DavenportEmma/sequencer/hardware/pcb/io/rotary-encoder-PEC11R-main/Bourns_-_PEC11R-4220F-S0024.step

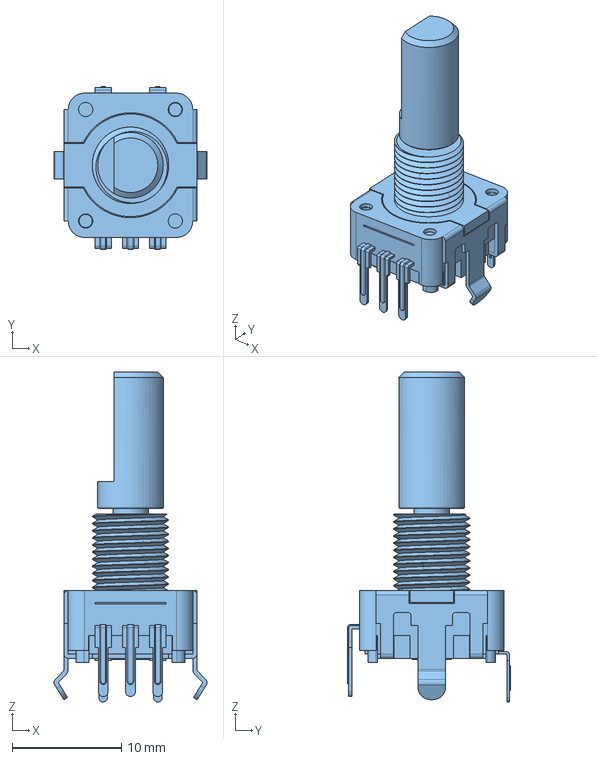
[picture p1: CAD file, 2025-04-29]
hardware/pcb/io/rotary-encoder-PEC11R-main/Bourns_-_PEC11R-4220F-S0024.step
14.0 x 14.9 x 30.2 mm
