DavenportEmma/sequencer/hardware/pcb/nucleo-hat/nucleo-hat.kicad_pcb

## KiCad design hardware/pcb/nucleo-hat/nucleo-hat.kicad_pcb (2025-05-08)

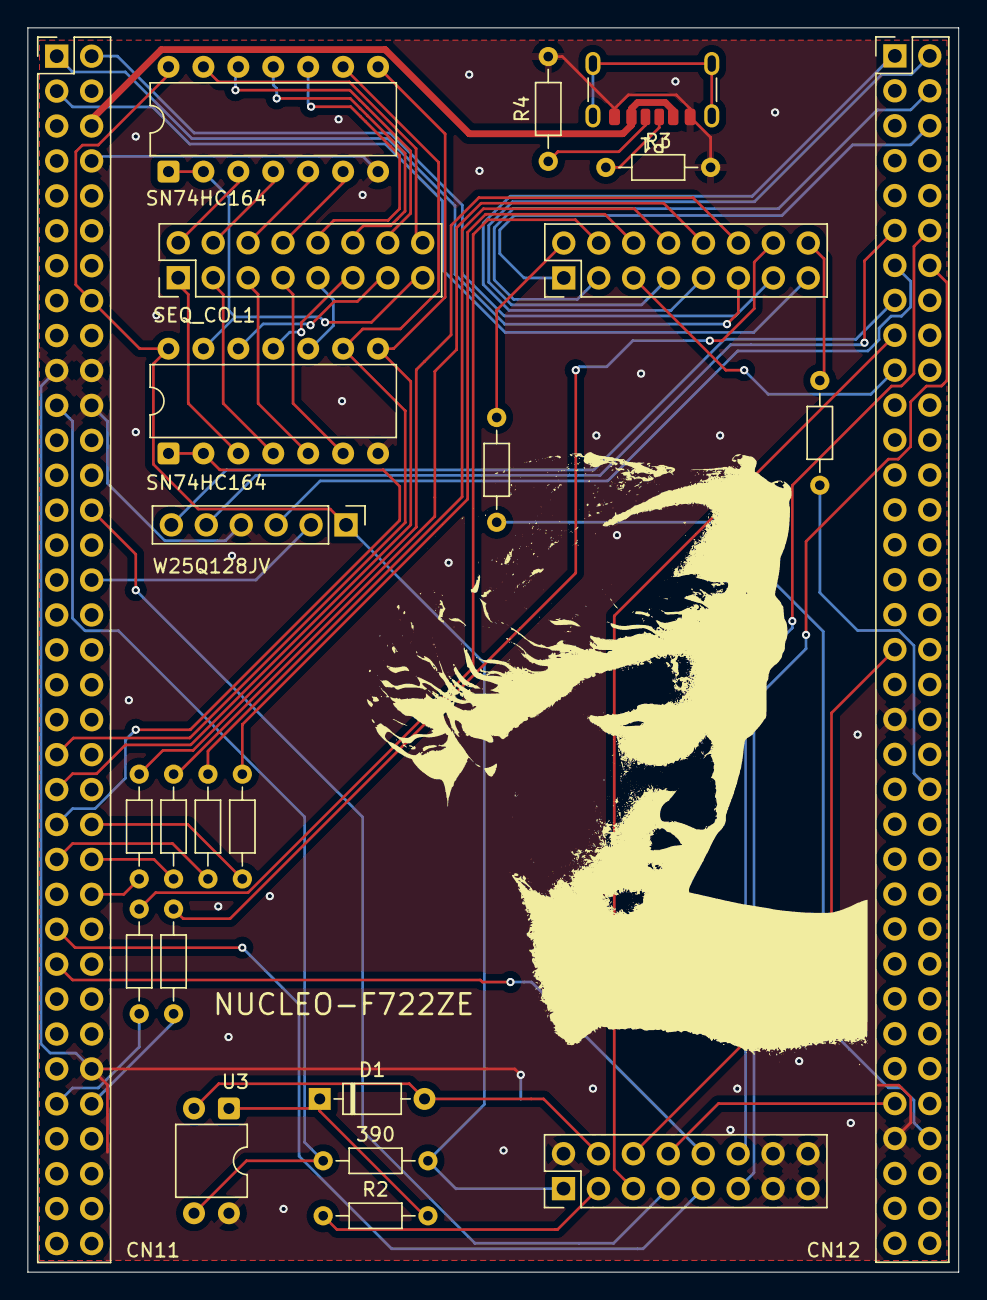
[picture p2: board nucleo-hat.kicad_pcb from above]

Board: 2 copper layers, 67.7 x 90.5 mm, 23 parts (0 on the bottom side), 64 nets.

Parts:
390: 390; R_Axial_DIN0204_L3.6mm_D1.6mm_P7.62mm_Horizontal
CN11, CN12: Conn_02x35_Odd_Even; PinHeader_2x35_P2.54mm_Vertical
D1: D; D_DO-35_SOD27_P7.62mm_Horizontal
IO1: Conn_02x08_Odd_Even; PinHeader_2x08_P2.54mm_Vertical
P1: USB_C_Plug_USB2.0; USB_C_Receptacle_GCT_USB4125-xx-x-0190_6P_TopMnt_Horizontal
R2: 330; R_Axial_DIN0204_L3.6mm_D1.6mm_P7.62mm_Horizontal
R3, R4: 1K5; R_Axial_DIN0204_L3.6mm_D1.6mm_P7.62mm_Horizontal
R5, R6, R7, R8, R9, R10, R11, R12: R; R_Axial_DIN0204_L3.6mm_D1.6mm_P7.62mm_Horizontal
SEQ_COL1: Conn_02x08_Odd_Even; PinHeader_2x08_P2.54mm_Vertical
SEQ_ROW1: Conn_02x08_Odd_Even; PinHeader_2x08_P2.54mm_Vertical
SN74HC164, SN74HC164#2: 74HC164; DIP-14_W7.62mm
U3: SFH617A-1; DIP-4_W7.62mm
W25Q128JV : Conn_01x06; PinHeader_1x06_P2.54mm_Vertical

Connections:
3.3: 390.2, CN11.16, IO1.1, SN74HC164.14 (VCC), SN74HC164#2.14 (VCC), W25Q128JV.1
E5V: CN11.6, P1.A9 (VBUS), P1.B9 (VBUS)
GND: CN11.8, CN11.19, CN11.20, CN11.22, CN11.60, CN12.39, CN12.63, IO1.2, IO1.13, IO1.14, IO1.15, IO1.16, P1.A12 (GND), P1.B12 (GND), R3.2, R4.2, SN74HC164.7 (GND), SN74HC164#2.7 (GND), U3.4, W25Q128JV.4
MIDI_IN_GND: D1.2 (A), IO1.4, U3.2
MIDI_IN_SRC: IO1.3, R2.1
unnamed: D1.1 (K), R2.2, U3.1
unnamed: P1.A5 (CC), R3.1
unnamed: P1.B5 (VCONN), R4.1
unnamed: SEQ_COL1.1, SN74HC164#2.3 (Q0)
unnamed: SEQ_COL1.2, SN74HC164.3 (Q0)
unnamed: SEQ_COL1.3, SN74HC164#2.4 (Q1)
unnamed: SEQ_COL1.4, SN74HC164.4 (Q1)
unnamed: SEQ_COL1.5, SN74HC164#2.5 (Q2)
unnamed: SEQ_COL1.6, SN74HC164.5 (Q2)
unnamed: SEQ_COL1.7, SN74HC164#2.6 (Q3)
unnamed: SEQ_COL1.8, SN74HC164.6 (Q3)
unnamed: SEQ_COL1.9, SN74HC164#2.10 (Q4)
unnamed: SEQ_COL1.10, SN74HC164.10 (Q4)
unnamed: SEQ_COL1.11, SN74HC164#2.11 (Q5)
unnamed: SEQ_COL1.12, SN74HC164.11 (Q5)
unnamed: SEQ_COL1.13, SN74HC164#2.12 (Q6)
unnamed: SEQ_COL1.14, SN74HC164.12 (Q6)
unnamed: SEQ_COL1.16, SN74HC164.13 (Q7)
unnamed: R5.1, SEQ_ROW1.2
unnamed: R6.1, SEQ_ROW1.4
unnamed: R7.1, SEQ_ROW1.6
unnamed: R8.1, SEQ_ROW1.8
unnamed: R9.1, SEQ_ROW1.10
unnamed: R10.1, SEQ_ROW1.12
unnamed: R11.1, SEQ_ROW1.14
unnamed: R12.1, SEQ_ROW1.16
PA0: CN11.28, IO1.7
PA2: CN12.35, IO1.6
PA4: CN11.32, W25Q128JV.2
PA5: CN12.11, W25Q128JV.5
PA6: CN12.13, W25Q128JV.3
PA7: CN12.15, W25Q128JV.6
PA11: CN12.14, IO1.11
PA12: CN12.12, IO1.12
PB6: CN12.17, IO1.5
PB7: 390.1, CN11.21, U3.3
PC5: CN12.6, SEQ_ROW1.1
PC6: CN12.4, SEQ_ROW1.3
PC7: CN12.19, SEQ_ROW1.5
PC8: CN12.2, SEQ_ROW1.7
PC9: CN12.1, SEQ_ROW1.9
PC10: CN11.1, SEQ_ROW1.11
PC11: CN11.2, SEQ_ROW1.13
PC12: CN11.3, SEQ_ROW1.15
PD5: CN11.41, SN74HC164.9 (~MR), SN74HC164#2.9 (~MR)
PD6: CN11.43, SN74HC164.8 (CP), SN74HC164#2.8 (CP)
PD7: CN11.45, SN74HC164#2.1 (DSA), SN74HC164#2.2 (DSB)
PE0: CN12.64, R5.2
PE1: CN11.61, R6.2
PE2: CN11.46, R7.2
PE3: CN11.47, R8.2
PE4: CN11.48, R9.2
PE5: CN11.50, R10.2
PE6: CN11.62, R11.2
PE7: CN12.44, R12.2
PF0: CN11.53, IO1.10
PF1: CN11.51, IO1.9
PG14: CN12.61, IO1.8
Q8: SEQ_COL1.15, SN74HC164.1 (DSA), SN74HC164.2 (DSB), SN74HC164#2.13 (Q7)
