DavenportEmma/sequencer/hardware/pcb/sequencer/sequencer.kicad_pcb

## KiCad design hardware/pcb/sequencer/sequencer.kicad_pcb (2025-04-29)

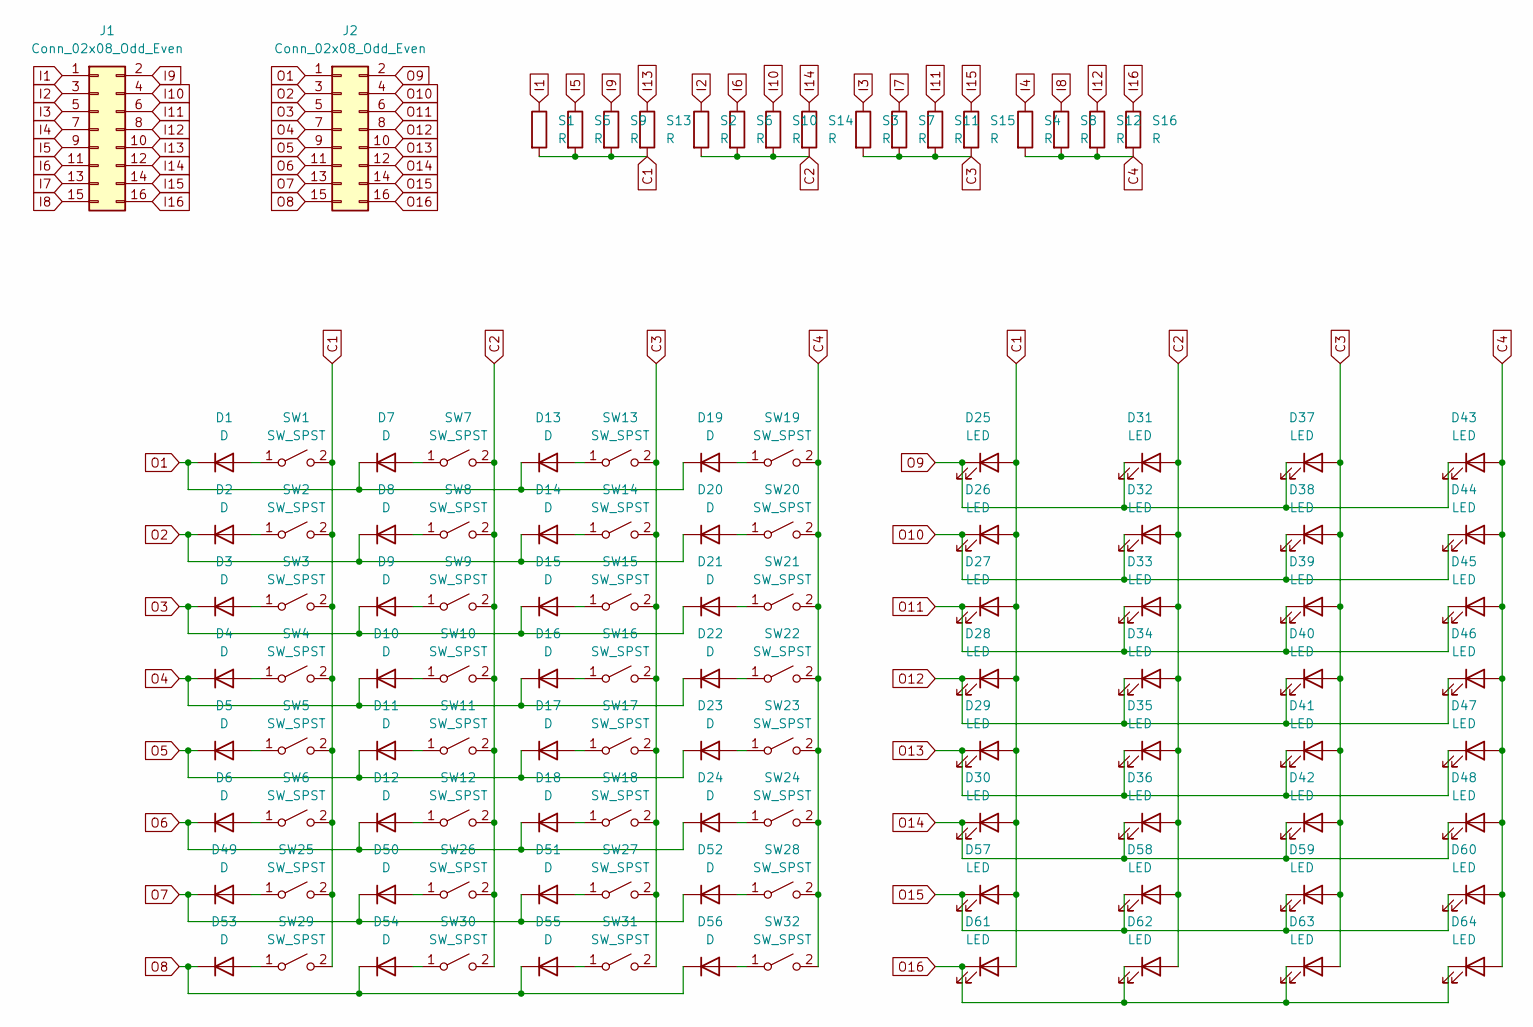
[picture p3: schematic sequencer.kicad_sch]

Parts:
D1, D2, D3, D4, D5, D6, D7, D8, D9, D10, D11, D12, D13, D14, D15, D16, D17, D18, D19, D20, D21, D22, D23, D24, D49, D50, D51, D52, D53, D54, D55, D56: D; D_DO-35_SOD27_P7.62mm_Horizontal
D25, D26, D27, D28, D29, D30, D31, D32, D33, D34, D35, D36, D37, D38, D39, D40, D41, D42, D43, D44, D45, D46, D47, D48, D57, D58, D59, D60, D61, D62, D63, D64: LED; LED_0805_2012Metric
J1, J2: Conn_02x08_Odd_Even; PinHeader_2x08_P2.54mm_Vertical
S1, S2, S3, S4, S5, S6, S7, S8, S9, S10, S11, S12, S13, S14, S15, S16: R; R_0603_1608Metric
SW1, SW2, SW3, SW4, SW5, SW6, SW7, SW8, SW9, SW10, SW11, SW12, SW13, SW14, SW15, SW16, SW17, SW18, SW19, SW20, SW21, SW22, SW23, SW24, SW25, SW26, SW27, SW28, SW29, SW30, SW31, SW32: SW_SPST; SW_Cherry_MX_1.00u_PCB

Connections:
C1: D25.2 (A), D26.2 (A), D27.2 (A), D28.2 (A), D29.2 (A), D30.2 (A), D57.2 (A), D61.2 (A), S1.2, S5.2, S9.2, S13.2, SW1.2 (B), SW2.2 (B), SW3.2 (B), SW4.2 (B), SW5.2 (B), SW6.2 (B), SW25.2 (B), SW29.2 (B)
C2: D31.2 (A), D32.2 (A), D33.2 (A), D34.2 (A), D35.2 (A), D36.2 (A), D58.2 (A), D62.2 (A), S2.2, S6.2, S10.2, S14.2, SW7.2 (B), SW8.2 (B), SW9.2 (B), SW10.2 (B), SW11.2 (B), SW12.2 (B), SW26.2 (B), SW30.2 (B)
C3: D37.2 (A), D38.2 (A), D39.2 (A), D40.2 (A), D41.2 (A), D42.2 (A), D59.2 (A), D63.2 (A), S3.2, S7.2, S11.2, S15.2, SW13.2 (B), SW14.2 (B), SW15.2 (B), SW16.2 (B), SW17.2 (B), SW18.2 (B), SW27.2 (B), SW31.2 (B)
C4: D43.2 (A), D44.2 (A), D45.2 (A), D46.2 (A), D47.2 (A), D48.2 (A), D60.2 (A), D64.2 (A), S4.2, S8.2, S12.2, S16.2, SW19.2 (B), SW20.2 (B), SW21.2 (B), SW22.2 (B), SW23.2 (B), SW24.2 (B), SW28.2 (B), SW32.2 (B)
I1: J1.1, S1.1
I2: J1.3, S2.1
I3: J1.5, S3.1
I4: J1.7, S4.1
I5: J1.9, S5.1
I6: J1.11, S6.1
I7: J1.13, S7.1
I8: J1.15, S8.1
I9: J1.2, S9.1
I10: J1.4, S10.1
I11: J1.6, S11.1
I12: J1.8, S12.1
I13: J1.10, S13.1
I14: J1.12, S14.1
I15: J1.14, S15.1
I16: J1.16, S16.1
unnamed: D1.2 (A), SW1.1 (A)
unnamed: D2.2 (A), SW2.1 (A)
unnamed: D3.2 (A), SW3.1 (A)
unnamed: D4.2 (A), SW4.1 (A)
unnamed: D5.2 (A), SW5.1 (A)
unnamed: D6.2 (A), SW6.1 (A)
unnamed: D7.2 (A), SW7.1 (A)
unnamed: D8.2 (A), SW8.1 (A)
unnamed: D9.2 (A), SW9.1 (A)
unnamed: D10.2 (A), SW10.1 (A)
unnamed: D11.2 (A), SW11.1 (A)
unnamed: D12.2 (A), SW12.1 (A)
unnamed: D13.2 (A), SW13.1 (A)
unnamed: D14.2 (A), SW14.1 (A)
unnamed: D15.2 (A), SW15.1 (A)
unnamed: D16.2 (A), SW16.1 (A)
unnamed: D17.2 (A), SW17.1 (A)
unnamed: D18.2 (A), SW18.1 (A)
unnamed: D19.2 (A), SW19.1 (A)
unnamed: D20.2 (A), SW20.1 (A)
unnamed: D21.2 (A), SW21.1 (A)
unnamed: D22.2 (A), SW22.1 (A)
unnamed: D23.2 (A), SW23.1 (A)
unnamed: D24.2 (A), SW24.1 (A)
unnamed: D49.2 (A), SW25.1 (A)
unnamed: D50.2 (A), SW26.1 (A)
unnamed: D51.2 (A), SW27.1 (A)
unnamed: D52.2 (A), SW28.1 (A)
unnamed: D53.2 (A), SW29.1 (A)
unnamed: D54.2 (A), SW30.1 (A)
unnamed: D55.2 (A), SW31.1 (A)
unnamed: D56.2 (A), SW32.1 (A)
O1: D1.1 (K), D7.1 (K), D13.1 (K), D19.1 (K), J2.1
O2: D2.1 (K), D8.1 (K), D14.1 (K), D20.1 (K), J2.3
O3: D3.1 (K), D9.1 (K), D15.1 (K), D21.1 (K), J2.5
O4: D4.1 (K), D10.1 (K), D16.1 (K), D22.1 (K), J2.7
O5: D5.1 (K), D11.1 (K), D17.1 (K), D23.1 (K), J2.9
O6: D6.1 (K), D12.1 (K), D18.1 (K), D24.1 (K), J2.11
O7: D49.1 (K), D50.1 (K), D51.1 (K), D52.1 (K), J2.13
O8: D53.1 (K), D54.1 (K), D55.1 (K), D56.1 (K), J2.15
O9: D25.1 (K), D31.1 (K), D37.1 (K), D43.1 (K), J2.2
O10: D26.1 (K), D32.1 (K), D38.1 (K), D44.1 (K), J2.4
O11: D27.1 (K), D33.1 (K), D39.1 (K), D45.1 (K), J2.6
O12: D28.1 (K), D34.1 (K), D40.1 (K), D46.1 (K), J2.8
O13: D29.1 (K), D35.1 (K), D41.1 (K), D47.1 (K), J2.10
O14: D30.1 (K), D36.1 (K), D42.1 (K), D48.1 (K), J2.12
O15: D57.1 (K), D58.1 (K), D59.1 (K), D60.1 (K), J2.14
O16: D61.1 (K), D62.1 (K), D63.1 (K), D64.1 (K), J2.16

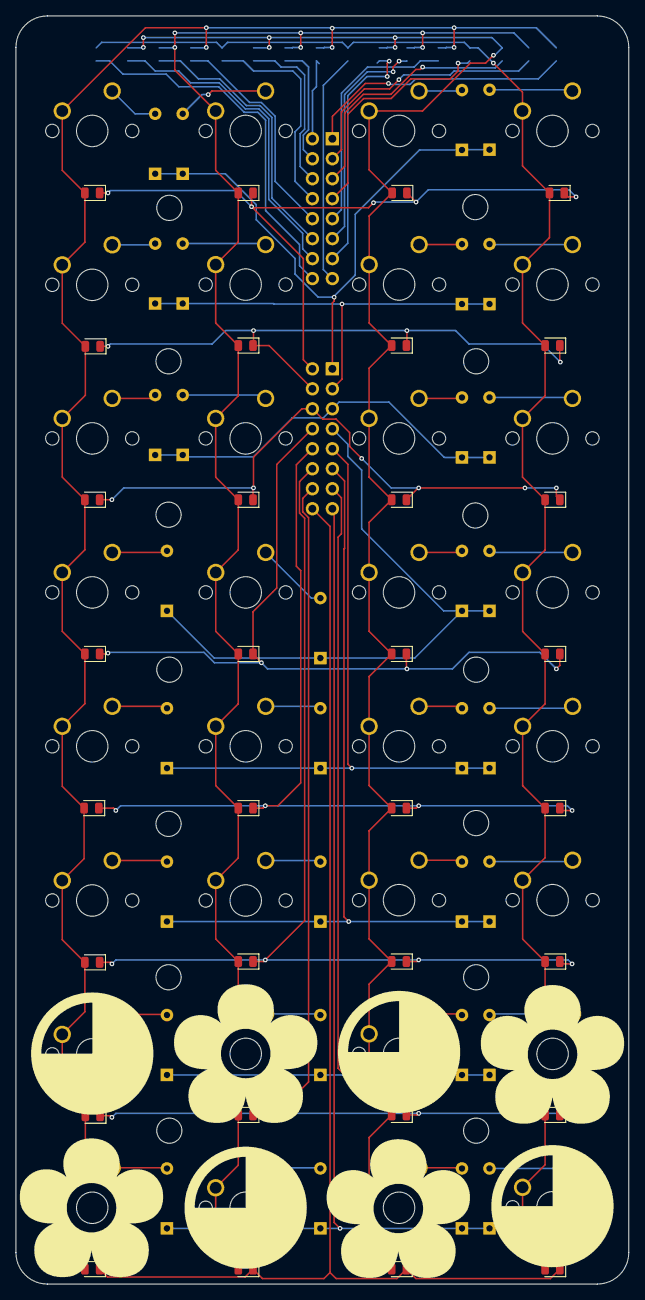
[picture p4: board sequencer.kicad_pcb from above]

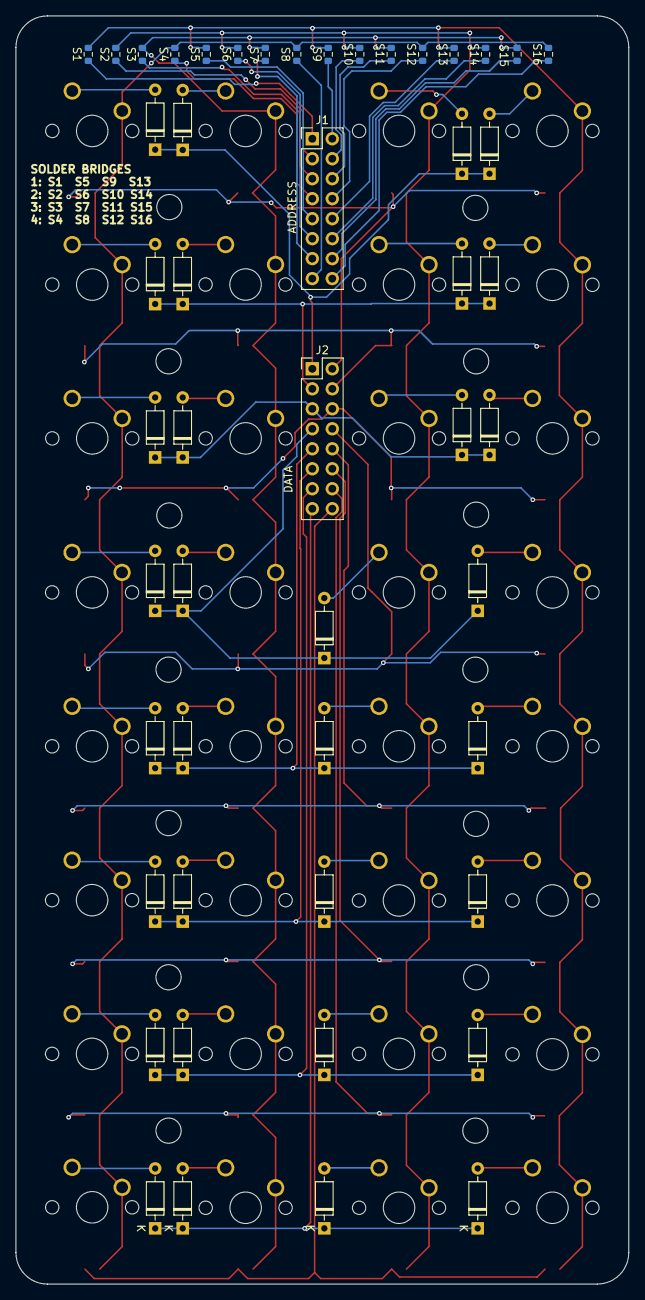
[picture p5: board sequencer.kicad_pcb from below]

Board: 2 copper layers, 77.9 x 161.2 mm, 114 parts (50 on the bottom side), 68 nets.
