DavenportEmma/sequencer/hardware/pcb/io/io.kicad_pcb

## KiCad design hardware/pcb/io/io.kicad_pcb (2025-04-29)

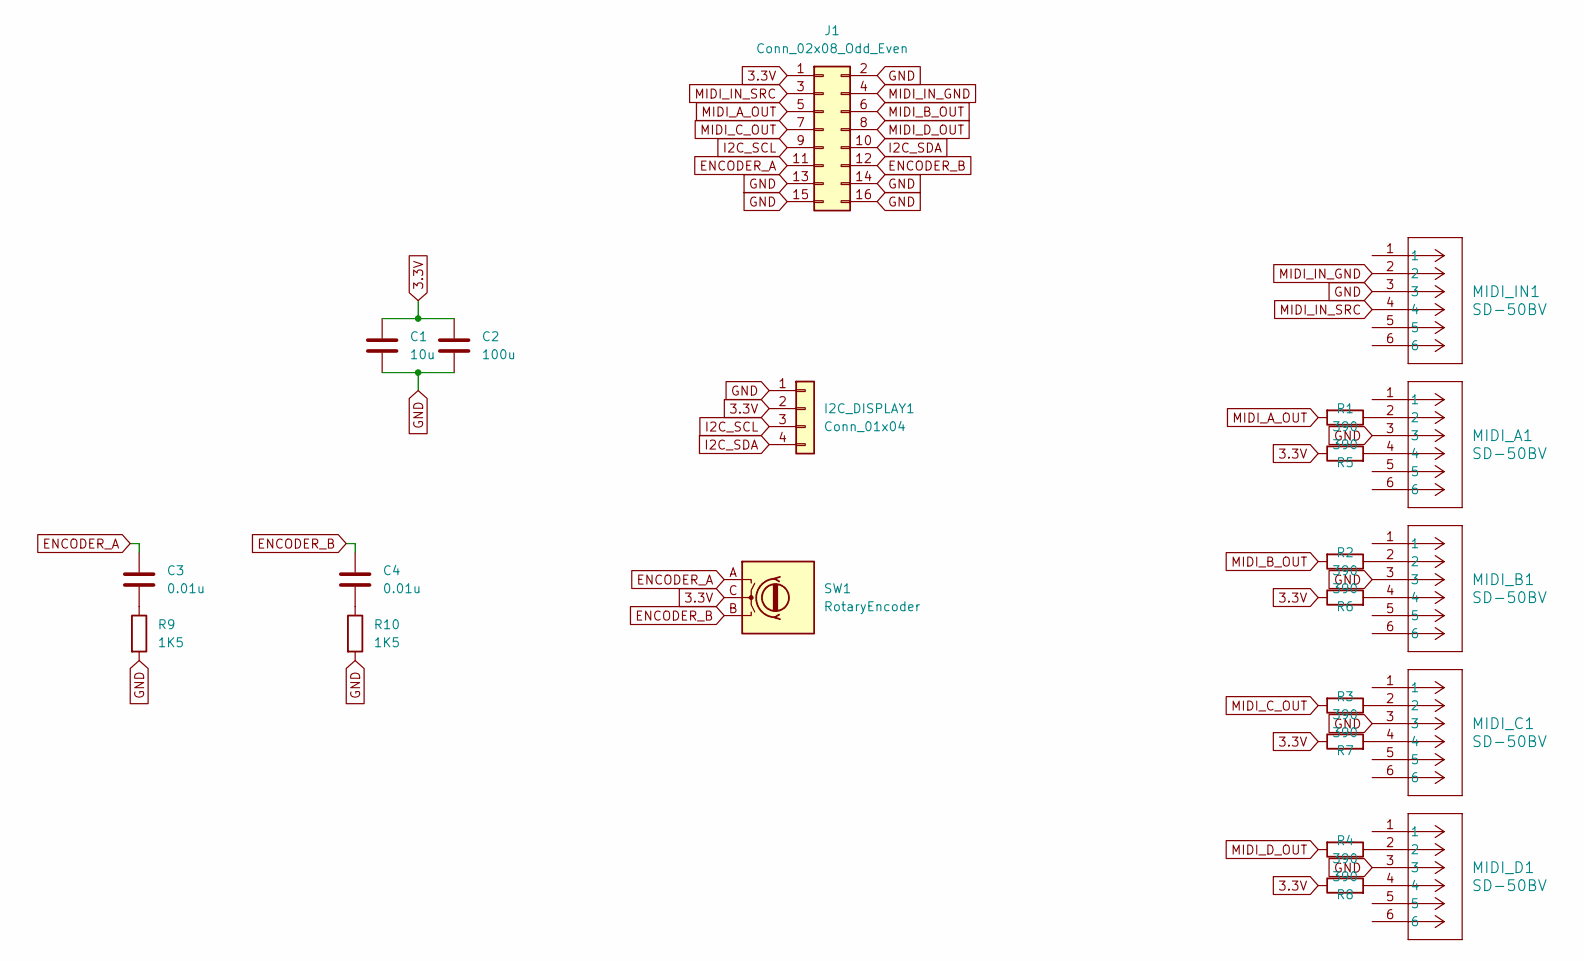
[picture p6: schematic io.kicad_sch]

Parts:
C1: 10u; CP_Radial_D5.0mm_P2.50mm
C2: 100u; CP_Radial_D5.0mm_P2.50mm
C3, C4: 0.01u; CP_Radial_D5.0mm_P2.50mm
I2C_DISPLAY1: Conn_01x04; PinHeader_1x04_P2.54mm_Vertical
J1: Conn_02x08_Odd_Even; PinHeader_2x08_P2.54mm_Vertical
MIDI_A1: SD-50BV; CONN6_SD-50BV_CUD
MIDI_B1: SD-50BV; CONN6_SD-50BV_CUD
MIDI_C1: SD-50BV; CONN6_SD-50BV_CUD
MIDI_D1: SD-50BV; CONN6_SD-50BV_CUD
MIDI_IN1: SD-50BV; CONN6_SD-50BV_CUD
R1, R2, R3, R4, R5, R6, R7, R8: 390; R_Axial_DIN0207_L6.3mm_D2.5mm_P10.16mm_Horizontal
R9, R10: 1K5; R_Axial_DIN0207_L6.3mm_D2.5mm_P10.16mm_Horizontal
SW1: RotaryEncoder; Bourns-PEC11R-4220F-S0024-0-0-0

Connections:
3.3V: C1.1, C2.1, I2C_DISPLAY1.2, J1.1, R1.1, R2.1, R3.1, R4.1, SW1.C
ENCODER_A: C3.1, J1.11, SW1.A
ENCODER_B: C4.1, J1.12, SW1.B
GND: C1.2, C2.2, I2C_DISPLAY1.1, J1.2, J1.13, J1.14, J1.15, J1.16, MIDI_A1.3, MIDI_B1.3, MIDI_C1.3, MIDI_D1.3, MIDI_IN1.3, R9.2, R10.2
I2C_SCL: I2C_DISPLAY1.3, J1.9
I2C_SDA: I2C_DISPLAY1.4, J1.10
MIDI_A_OUT: J1.5, R5.2
MIDI_B_OUT: J1.6, R6.2
MIDI_C_OUT: J1.7, R7.2
MIDI_D_OUT: J1.8, R8.2
MIDI_IN_GND: J1.4, MIDI_IN1.2
MIDI_IN_SRC: J1.3, MIDI_IN1.4
unnamed: C3.2, R9.1
unnamed: C4.2, R10.1
unnamed: MIDI_A1.2, R5.1
unnamed: MIDI_A1.4, R1.2
unnamed: MIDI_B1.2, R6.1
unnamed: MIDI_B1.4, R2.2
unnamed: MIDI_C1.2, R7.1
unnamed: MIDI_C1.4, R3.2
unnamed: MIDI_D1.2, R8.1
unnamed: MIDI_D1.4, R4.2

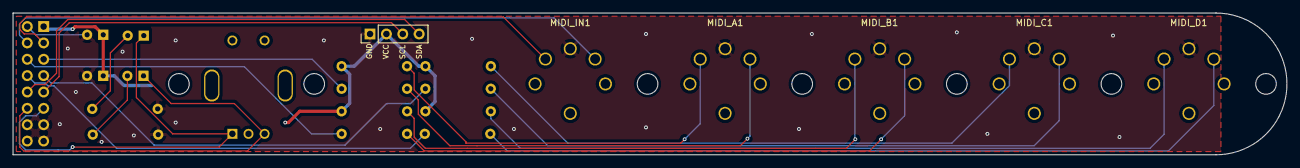
[picture p7: board io.kicad_pcb from above]

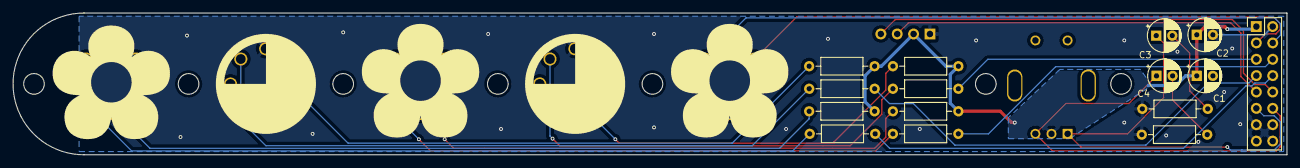
[picture p8: board io.kicad_pcb from below]

Board: 2 copper layers, 197.8 x 22.0 mm, 22 parts (15 on the bottom side), 22 nets.
