DavenportEmma/sequencer/software/inc/ascii.h

uint8_t font[] = {
	0x00, 0x00, 0x00, 0x00, 0x00,	// NULL
	0x3E, 0x5B, 0x4F, 0x5B, 0x3E,	// :q
	0x3E, 0x6B, 0x4F, 0x6B, 0x3E,	// :p
	0x1C, 0x3E, 0x7C, 0x3E, 0x1C,	// heart
	0x18, 0x3C, 0x7E, 0x3C, 0x18,	// diamond
	0x1C, 0x57, 0x7D, 0x57, 0x1C,	// club
	0x1C, 0x5E, 0x7F, 0x5E, 0x1C,	// spade
	0x00, 0x18, 0x3C, 0x18, 0x00,	// small diamond
	0xFF, 0xE7, 0xC3, 0xE7, 0xFF,	// small diamond card
	0x00, 0x18, 0x24, 0x18, 0x00,	// hollow diamond
	0xFF, 0xE7, 0xDB, 0xE7, 0xFF,	// hollow diamond card
	0x30, 0x48, 0x3A, 0x06, 0x0E,	// male
	0x26, 0x29, 0x79, 0x29, 0x26,	// female
	0x40, 0x7F, 0x05, 0x05, 0x07,	// weird P
	0x40, 0x7F, 0x05, 0x25, 0x3F,	// weird A
	0x5A, 0x3C, 0xE7, 0x3C, 0x5A,	// eye of sauron
	0x7F, 0x3E, 0x1C, 0x1C, 0x08,	// right arrow
	0x08, 0x1C, 0x1C, 0x3E, 0x7F,	// left arrow
	0x14, 0x22, 0x7F, 0x22, 0x14,	// up and down arrow
	0x5F, 0x5F, 0x00, 0x5F, 0x5F,	// double !
	0x06, 0x09, 0x7F, 0x01, 0x7F,	// paragraph marker
	0x00, 0x66, 0x89, 0x95, 0x6A,	// fancy S
	0x60, 0x60, 0x60, 0x60, 0x60,	// underscore
	0x94, 0xA2, 0xFF, 0xA2, 0x94,	// up and down arrow
	0x08, 0x04, 0x7E, 0x04, 0x08,	// thin up arrow
	0x10, 0x20, 0x7E, 0x20, 0x10,	// thin down arrow 
	0x08, 0x08, 0x2A, 0x1C, 0x08,	// thin right arrow
	0x08, 0x1C, 0x2A, 0x08, 0x08,	// thin left arrow
	0x1E, 0x10, 0x10, 0x10, 0x10,	// |_
	0x0C, 0x1E, 0x0C, 0x1E, 0x0C,	// double bubble thing
	0x30, 0x38, 0x3E, 0x38, 0x30,	// upside down acorn hat
	0x06, 0x0E, 0x3E, 0x0E, 0x06,	// acorn hat
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
	0xFC,0xFC,0x80,0x00,0x00,0x00,0x00,0x80,0xFC,0xFC,0x00,0x01,0x03,0x07,0xFE,0xFE,0x07,0x03,0x01,0x00, // Y
	0x0C,0x0C,0x0C,0x0C,0x0C,0x8C,0xCC,0xEC,0x7C,0x3C,0xF0,0xF8,0xDC,0xCE,0xC7,0xC3,0xC1,0xC0,0xC0,0xC0, // Z
};	
