DavenportEmma/sequencer/software/src/setup.c

#include "stm32f722xx.h"
#include "uart.h"
#include "spi.h"
#include "midi.h"
#include "w25q128jv.h"
#include "keyboard.h"
#include "menu.h"
#include "sequence.h"
#include "i2c.h"
#include "ssd1306.h"
#include "FreeRTOS.h"
#include <string.h>
#include "display.h"
#include "common.h"

uint8_t display_buffer[DISPLAY_BUFFER_SIZE];

void setup(MIDISequence_t* sequences) {
    /*
    setup uart for st link
    setup uart for midi
    setup spi flash chip
    setup gpio for keyboard
    */
   int err;

    USART_Handler u;
    u.uart = USART3;
    u.baud = 9600;
    u.gpio = GPIOD;
    u.tx_pin = 8;
    u.rx_pin = 9;
    u.afr_reg = 1;
    u.rx_interrupts = 0;
    u.afr_mode = 7;

    err = init_uart(&u);
    if(err == 0) {
        send_uart(USART3, "ST-Link UART initialised\n\r", 26);
    }

    u.uart = USART1;
    u.baud = 31250;
    u.gpio = GPIOB;
    u.tx_pin = 6;
    u.rx_pin = 7;
    u.afr_reg = 0;
    u.rx_interrupts = 1;
    u.afr_mode = 7;

    err = init_uart(&u);
    if(err) {
        send_uart(USART3, "Error initialising MIDI A UART\n\r", 30);
    }
    
    u.uart = USART2;
    u.baud = 31250;
    u.gpio = GPIOA;
    u.tx_pin = 2;
    u.rx_pin = 3;
    u.afr_reg = 0;
    u.rx_interrupts = 0;
    u.afr_mode = 7;

    err = init_uart(&u);
    if(err) {
        send_uart(USART3, "Error initialising MIDI B UART\n\r", 30);
    }

    u.uart = UART4;
    u.baud = 31250;
    u.gpio = GPIOA;
    u.tx_pin = 0;
    u.rx_pin = 1;
    u.afr_reg = 0;
    u.rx_interrupts = 0;
    u.afr_mode = 8;

    err = init_uart(&u);
    if(err) {
        send_uart(USART3, "Error initialising MIDI C UART\n\r", 30);
    }

    u.uart = USART6;
    u.baud = 31250;
    u.gpio = GPIOG;
    u.tx_pin = 14;
    u.rx_pin = 9;
    u.afr_reg = 1;
    u.rx_interrupts = 0;
    u.afr_mode = 8;

    err = init_uart(&u);
    if(err) {
        send_uart(USART3, "Error initialising MIDI D UART\n\r", 30);
    }

    NVIC_EnableIRQ(USART1_IRQn);

    SPI_Handler s;
    s.spi = SPI1;
    s.gpio = GPIOA;
    s.miso = 6;
    s.mosi = 7;
    s.clk = 5;
    s.cs = 4;

    err = init_spi(&s);
    if(err) {
        send_uart(USART3, "Error initialising SPI\n\r", 24);
    }

    uint8_t tx[] = {0x9F, 0x00, 0x00, 0x00};
    uint8_t rx[4];
    CS_low(GPIOA, 4);
    SPI_tx_rx(SPI1, tx, rx, 4);
    CS_high(GPIOA, 4);
    if(rx[1] != 0xEF || rx[2] != 0x40 || rx[3] != 0x18) {
        send_uart(USART3, "Error initialising SPI flash chip\n\r", 34);
    }

    err = init_sequences();
    if(err) {
        send_uart(USART3, "Error initialising sequences\n\r", 30);
    }

    init_i2c();
    init_ssd1306();

    memset(display_buffer, 0, 1024);
    clear_display();

    // shift register
    // initialise gpio
    RCC->AHB1ENR |= RCC_AHB1ENR_GPIODEN;
    GPIOD->MODER |= 0x5400;
    GPIOD->ODR |= 0x0000;
    // pull CLR high
    GPIOD->ODR |= CLR;

    // column input pins
    RCC->AHB1ENR |= RCC_AHB1ENR_GPIOCEN;
    // port C defaults to input on all pins
    // enable pull down resistors
    GPIOC->PUPDR |= (2 << (ROW_INPUT_0_PIN * 2)) | (2 << (ROW_INPUT_1_PIN * 2)) |
                    (2 << (ROW_INPUT_2_PIN * 2)) | (2 << (ROW_INPUT_3_PIN * 2)) |
                    (2 << (ROW_INPUT_4_PIN * 2)) | (2 << (ROW_INPUT_5_PIN * 2)) |
                    (2 << (ROW_INPUT_6_PIN * 2)) | (2 << (ROW_INPUT_7_PIN * 2));
    
    keyboard_t k;
    kb_handle_t kb = &k;

    kb_reset(kb);

    scan(kb);

    #ifdef CONFIG_ENABLE_STARTUP_MEMORY_CLEAR
    if(!kbuf_empty(kbuf)) {
        send_uart(USART3, "Start up key press\n\r", 20);
        send_uart(USART3, "Erasing flash\n\r", 15);
        eraseChip();
    }
    #endif

    // initialise menu state machine
    menu(E_MAIN_MENU, E_NO_HOLD);

    // rotary encoder
    RCC->AHB1ENR |= RCC_AHB1ENR_GPIOAEN;                // enable gpioa
    GPIOA->MODER &= ~((3 << GPIO_MODER_MODER12_Pos) | (3 << GPIO_MODER_MODER11_Pos));
    GPIOA->PUPDR |= ((2 << 24) | (2 << 22));            // pull down resistors

    EXTI->IMR |= (EXTI_EMR_EM11 | EXTI_EMR_EM12);       // enable interrupts
    EXTI->RTSR |= (EXTI_RTSR_TR11 | EXTI_RTSR_TR12);    // enable rising edge int

    NVIC_EnableIRQ(EXTI15_10_IRQn);
    
    send_uart(USART3, "Finished initialisation\n\r", 25);
}
