DavenportEmma/sequencer/software/inc/util.h

#ifndef _UTIL_H
#define _UTIL_H

#include <stdint.h>

void toggle_bit(uint32_t* field, uint8_t bit, uint8_t max);
uint8_t check_bit(uint32_t* field, uint8_t bit, uint8_t max);
void clear_field(uint32_t* field, uint8_t max);
void set_bit(uint32_t* field, uint8_t bit, uint8_t max);
void clear_bit(uint32_t* field, uint8_t bit, uint8_t max);
void set_bit_range(uint32_t* field, uint8_t start, uint8_t end, uint8_t max);
uint8_t one_bit_set(uint32_t* field);
uint8_t find_last_bit(uint32_t* field);
uint8_t find_first_bit(uint32_t* field);

#endif // _UTIL_H
