DavenportEmma/sequencer/(commit log)

2025-03-28 hardware: add kicad project
    [sequencer.kicad_pcb, sequencer.kicad_sch]
2025-03-28 sequencer: update pcb layout
    [sequencer.kicad_pcb, sequencer.kicad_sch]
2025-03-28 sequencer: route pcb
    [sequencer.kicad_pcb, sequencer.kicad_sch]
2025-03-28 sequencer: redue board size
    [sequencer.kicad_pcb]
2025-03-28 keys: add pcb for 13 note keyboard
    [keys.kicad_pcb, keys.kicad_sch]
2025-03-28 controls: add pcb design for note control keys
    [controls.kicad_pcb, controls.kicad_sch]
2025-03-28 main: remove references to menu task
    the menu handling will be done from the key scan task as that is where
    user inputs are processed. dealing with messages being passed between
    tasks is going to take too much time and slow project momentum
    [main.c]
2025-03-28 menu: update state flow
2025-03-28 menu: minor debug print updates
2025-03-28 tasks: call play_sequences()
    this function reads midi data from the flash chip and sends to uart
2025-03-28 main: intialise sq_states array
    this keeps track of all the sequences that are enabled and their meta
    data
2025-03-28 sequence: turn off notes on sequence disable
    this prevents a note from ringing out when a sequence is turned off
    [sequence.c]
2025-03-28 sequence: replace buffer_max with preproc def
    [sequence.c]
2025-03-28 menu: add carriage return to prints
2025-03-28 setup: add carriage return to prince 🤴
2025-03-28 sequence: add reset_step_edit_buffer()
    this resets the values of the step edit buffer to all 0xFF
    [sequence.c, sequence.h]
2025-03-28 menu: make volatile ACTIVE_SQ and ACTIVE_ST
    these are going to be read by different tasks, make volatile to avoid
    compiler optimisation
    [menu.c]
2025-03-28 menu: reset step edit buffer on main menu
    and set the buffer ready flag to zero
    [menu.c]
2025-03-28 sequence: add carriage return to prince 🤴
2025-03-28 menu: update state table
    allow sq_en transition from step landing and menu
2025-03-28 sequence: handle playing from edit buffer
    when editing a sequence we load the notes into the edit buffer. if this
    sequence is currently being played we want it to continue playing as we
    are editing it
2025-03-28 tasks: remove unnecessary prints
2025-03-28 menu: update menu prints
2025-03-28 menu: change to switch case in decode_key()
2025-03-28 menu: update prints
2025-03-31 menu: only reset edit buffer if SQ_EDIT_READY
    prevents eronious calls to reset buffer
    [menu.c]
2025-04-11 .gitignore: ignore some kicad files
2025-04-11 hardware: add schematics
    add controls, io, keys, and nucleo hat boards
    [controls.kicad_pcb, controls.kicad_sch, io.kicad_pcb, io.kicad_sch, keys.kicad_pcb, keys.kicad_sch, nucleo-hat.kicad_pcb, nucleo-hat.kicad_sch]
2025-04-17 src: change sq_states to sequences
    I think the name sq_states didn't reflect accurately what this array
    was being used for
    [main.c, sequence.c]
2025-04-19 sequence: reset step counter to 0 on disable
    this can be switched on or off using RESET_SEQ_ON_DISABLE kconfig option
    [sequence.c]
2025-04-19 setup: enable usart1 interrupts
2025-04-19 menu: initialise kbuf for midi rx
    this will be filled with data in the usart rx interrupt handler
2025-04-19 tasks: fix tempo divisor
    the tempo divisor was too high
    [tasks.c]
2025-04-19 menu: only load edit buffer if ready flag is 0
    this will prevent errors where an attempt is made to load the edit
    buffer twice
    [menu.c]
2025-04-23 sequence: handle muted steps
    muted steps will still play i.e. they won't be skipped over by the
    sequencer but only the note_off packets will be sent
    [sequence.c]
2025-04-23 rotary_encoder: add driver for encoder
2025-04-23 CMakeLists: include rotary encoder src code
2025-04-23 setup: initialise io for rotary encoder
2025-04-23 rotary_encoder: reverse direction
    how I've set the encoder up was incrementing on anti clockwise
    [rotary_encoder.c]
2025-04-23 menu: add encoder up and down events
2025-04-23 sequence: fix enabling sequence
    it wasn't enabling the sequence 😲
    [sequence.c]
2025-04-23 tasks: handle encoder events
    pass encoder up and down events to the state machine if such an event
    happens
2025-04-23 menu: change midi channel with rotary encoder
2025-04-23 step_editor: abstract toggle_bit() to own func
    now point typing the same stuff over again 🤠
2025-04-23 step_editor: toggle_step prototype 🤖
2025-04-25 menu: add prev and next step buttons
2025-04-25 menu: edit velocity on encoder movement
2025-04-25 pcb: move everything to sequencer pcb
    [controls.kicad_pcb, controls.kicad_sch, keys.kicad_pcb, keys.kicad_sch]
2025-04-25 sequencer: add flower and circle decals
2025-04-25 sequencer: move keys and controls to this pcb
    it's just easier to do it this way
    [sequencer.kicad_pcb, sequencer.kicad_sch]
2025-04-25 sequencer: move keys closer together
    [sequencer.kicad_pcb]
2025-04-29 pcb: version 1 for all boards
    [Bourns_-_PEC11R-4220F-S0024.step, io.kicad_pcb, io.kicad_sch, nucleo-hat.kicad_pcb, nucleo-hat.kicad_sch, sequencer.kicad_pcb, sequencer.kicad_sch]
2025-05-01 software: remove autoconf, stm32f722xx
    remove the inclusion of thee files and include them via compiler flags.
    this will make it easier to support other devices
2025-05-03 menu: handle sequence clear button press
2025-05-03 step_edit_buffer: use flash wrappers
    use flash wrappers for spi flash chip access
2025-05-03 sequence: use flash wrappers
    use flash wrappers to protect spi flash chip access
2025-05-05 menu: add ctrl and shift buttons
2025-05-06 menu: clean up extraneous uart sends
2025-05-06 step_editor: clean up extraneous uart sends
2025-05-08 nucleo-hat: make updates after getting board
    [nucleo-hat.kicad_pcb]
2025-05-17 step_editor: make better use of mutexes
    use st_mask_mutex to protect the enabling/disabling and muting of steps
    use edit_buffer_mutex to protect step clearing and step velocity
    updating
2025-05-28 display: add driver for ssd1306
2025-05-28 proj: include i2c and ssd1306 drivers
2025-05-28 CMakeLists: include driver.c in src files
2025-05-28 setup: initialise i2c and ssd1306
2025-05-28 menu: print to display for menu states
2025-05-28 display: add num_to_str
    this function takes number n, and char array s and converts the number
    to a string compatible with the ssd1306 driver
2025-06-22 menu: move menu button
2025-06-22 step_editor: add polyphony for edit step velocity
    change the velocity for all notes in the step
2025-06-22 step_edit_buffer: remove unused prototype
2025-06-22 menu: update st_note to use new edit_step_note
    big things are happening 🤠
2025-09-22 menu: add debug prints cos i2c display broken
    [menu.c]
2025-10-19 flash: reflect updates to flash driver in platform
    change the read length for spi read from 16b to 32b for longer reads
2025-10-19 menu: add save state
    to save current sequences to the flash chip
2025-10-19 src: read all sequences from ram
    I apologise for this massive commit but I'm so tired and if I don't do
    this now I think I'll die
    on startup read all sequence data from the flash chip into structures
    in ram. this removes the need for the step edit buffer and significantly
    improves performance with a downside being larger memory requirements
    but at this point I just want to get this project over and done with so
    I don't really care anymore
2025-10-27 rotary_encoder: fix direction
    fix direction to clockwise increment, counter-clockwise decrement
    [rotary_encoder.c]
2025-11-01 common: add display buffer size
    used for the display buffer for the i2c display
2025-11-01 setup: remove use of malloc for display buffer
    we can statically allocate this as we're never going to need to de-alloc
    this memory
2025-11-01 sequence: fix problem with out of sync queueing
    update load_sequences to start playing any sequences that have been
    queued but have not been enabled yet
    [sequence.c]
2025-11-01 src: add support for sequence break
    this stops the sequence playing at the end of this current loop
2025-11-02 setup: enable uart1 rx intr on start up
2025-11-02 sequence: handle first step disabled error
    if the first step of the sequence is disabled it wasn't properly queuing
    or breaking. this fixes that
    [sequence.c]
2025-11-09 setup: initialise more uart ports
    initialise usart2, uart4, usart6 for midi port B, C, D on the sequencer
2025-11-09 sequence: handle multiple midi out ports
    i'm pretty tired so this is the best commit message you're going to get
2025-11-09 tasks: add port num to uart tx task params
2025-11-09 sequence: handle all steps disabled
    advance onto the next enabled step, skipping any disabled steps. when this
    step is found, update the counter, and return 0. if we have looped the
    entire way back to where we began without finding an enabled step, break the
    loop and return 1
    [sequence.c]
2025-11-11 menu: update midi thru
    let the user play midi instruments through the sequencer by routing the
    data from the input directly to the output. Intercept the data and
    update the channel information if a sequence is currently selected
2025-11-12 menu: fix type error
    [menu.c]
2025-11-13 main: create uart mutex
    this prevents multiple tasks from sending midi uart data at the same
    time
    [main.c]
2025-11-13 tasks: use uart mutex when sending midi data
2025-11-14 sequence: got prescaler working 🥳
2025-11-16 menu: update i2c display prints
2025-11-16 update note editing functions
    solve the mystery of the missing midi notes. I always end up writing
    commits when I'm really tired. I got barely any sleep last night. Who
    is even going to be reading this? Hello future me 👋
    [menu.c, step_editor.c, step_editor.h]
2025-11-16 sequence: handle disabled step bug
    previously an all notes off signal was not being sent to the synth if
    there was a disabled step present in the sequence
    [sequence.c]
2025-11-23 sequence: erase entire chip before save
    instead of erasing sectors, nuke the whole chip. this was causing errors
    where not all the sequence data was being saved
    [sequence.c]
2025-11-29 step_editor: add get_step_velocity() for printing
2025-11-29 menu: display step velocity when editing st vel
2025-12-07 display: add error handling for clear_line
    this prevents buffer overflows
    [display.c]
2025-12-07 display: add piano roll and note display
    this will print a piano roll to the bottom of the display and highlight
    notes passed to it
2025-12-07 step_edit_buffer: rename to avoid confusion
    [zzzstep_edit_buffer.c]
2025-12-07 display: fix bug with note class
    [display.c]
2025-12-13 step_editor: add more debug serial prints
    print error when push note_on/note_off fifo for loop exits before a
    note is pushed to the buffer
    [step_editor.c]
2025-12-13 step_editor: remove note msb masking
    the note_on/note_off circular buffers need to be redesigned from the
    ground up
    [step_editor.c]
2025-12-13 util: add end return value for find last/first bit
    preventing warnings 🤠
    [util.c]
2025-12-15 tasks: update uart task params
    pass the pointer for the usart port directly to the task instead of
    a numerical representation
2025-12-15 util: fix off by one error in find last bit
    [util.c]
2025-12-15 tasks: add dedicated save task
    prevents user inputs from hanging while the sequences are being saved
    [tasks.c, tasks.h]
2025-12-15 menu: release save task when save button pressed
    this kicks off a lower priority task that saves sequence data to the
    flash chip
2025-12-20 menu: switch output port for ext midi controller
    depending on which sequence is active, switch the output port
2026-06-29 menu: add getActivePort and getActiveChannel
    helpers 😊
2026-07-02 menu: update uart interrupt
    use a queue to pass incoming midi data from an external controller to
    the midi stream task. This prevents potential problems with hanging uart
    send handlers in an IRQ
2026-07-02 main: initialise midi mutex timer
    when midi data is passed through the sequencer from an external
    controller the midi stream task takes the midi uart mutex for the
    duration of this timer
2026-07-02 check midi_uart_mutex_held instead of timer
    just look at the comments
2026-07-02 menu: aggressively set uart kbuf ready
    if a midi packet has been received and the buffer
    isn't ready, always set uart_intr_kbuf.ready to 0
